Gautam-Gandhi/3-Lead-ECG-Monitoring-System/README.md

You can see the video demonstration here - https://youtu.be/dWgcyv5FcN8
