Gautam-Gandhi/3-Lead-ECG-Monitoring-System/LtSpice/ECG.asc

B1: bv; V=2m*white(50*time)
C1: cap; 20µ
C2: cap; 10µ
C3: cap; 10n
C4: cap; 1µ
C5: cap; 1µ
C6: cap; 2.2µ
C7: cap; 1µ
C8: cap; 1µ
C9: cap; 2.2µ
C11: cap; 4.7µ
C12: cap; 0.1µ
Q1: npn; BC547B
R1: res; 6.2k
R2: res; 47k
R3: res; 47k
R4: res; 1.5k
R5: res; 1.5k
R6: res; 100k
R7: res; 100k
R8: res; 23.5k
R9: res; 47k
R10: res; 47k
R11: res; 40k
R12: res; 3.3k
R13: res; 3.3k
R14: res; 1.2k
R15: res; 1.5k
R17: res; 1240
R18: res; 3.3k
R19: res; 3.3k
R20: res; 33k
R21: res; 33k
R22: res; 1k
Re1: res; 1Meg
U1: opamp2; UA741
U2: opamp2; UA741
U3: opamp2; UA741
U4: opamp2; UA741
U5: opamp2; UA741
V1: voltage; SINE(0 1m 5); AC 5m
V2: voltage; 0
V3: voltage; 12
V4: voltage; -12
V5: voltage; 5
Named nets: 0, v+12, v-12, Vout, out_instr_amp
.include UA741.301
.tran 1000m
